SALLAH-JP/PFE/assets/images/marc.gif

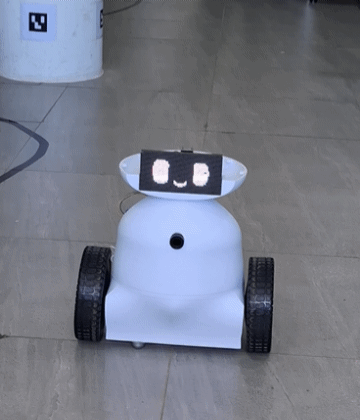
assets/images/marc.gif
