SALLAH-JP/PFE/controlMoteur/controlMoteur.ino

#include "header.h"


void setup() {
  Serial.begin(115200);

  Serial.println("Start Setup");


  //if (myIMU.begin() == false) {  // Setup without INT/RST control (Not Recommended)
  while (imu.beginSPI(BNO08X_CS, BNO08X_INT, BNO08X_RST) == false) {
    Serial.println("BNO08x not detected at default I2C address. Check your jumpers and the hookup guide. Freezing...");
    delay(100);
  }
  Serial.println("BNO08x found!");


  delay(100);
  setReports();
  Serial.println("Reading events");
  delay(100);

  // IR Receiver Setup and interrupt
  IrReceiver.begin(IR_PIN, ENABLE_LED_FEEDBACK);


  // Activer les moteurs
  engine.init();

  // Moteur droit
  motorR = engine.stepperConnectToPin(STEP_PIN_R);   // STEP droit
  if (motorR) {
    motorR->setDirectionPin(DIR_PIN_R);            // DIR droit
    motorR->setEnablePin(ENA_PIN_R, false);               // EN droit
    motorR->setAutoEnable(true);
    motorR->setAcceleration(3000);
  }

  // Moteur gauche
  motorL = engine.stepperConnectToPin(STEP_PIN_L);   // STEP gauche
  if (motorL) {
    motorL->setDirectionPin(DIR_PIN_L);            // DIR gauche
    motorL->setEnablePin(ENA_PIN_L, false);               // EN gauche
    motorL->setAutoEnable(true);
    motorL->setAcceleration(3000);
  }


  // Tracking Sensor Setup
  pinMode(LEFT_SENSOR_PIN, INPUT);
  pinMode(RIGHT_SENSOR_PIN, INPUT);
  pinMode(CENTER_SENSOR_PIN, INPUT);

  setupUltrasons();

  // PID
  pidA.SetSampleTime(10);
  pidA.SetOutputLimits(-5000, 5000);
  pidA.SetMode(AUTOMATIC);

  pidV.SetSampleTime(10);
  pidV.SetOutputLimits(-45, 45);
  pidV.SetMode(AUTOMATIC);


  Serial.println("Setup Completed !");
}


void loop() {

  if (imu.wasReset()) {
    Serial.print("sensor was reset ");
    setReports();
  }

  moveCmd = 0;
  turnCmd = 0;

  readSerialCommand();


  if (lineFollowingMode) {
    lineTracking();        // suit la ligne, ignore la télécommande
  } else {
    remoteControl();       // télécommande active, pas de suivi
  }

  // filtrage passe-bas des commandes
  currentMoveCmd = moveCmd; //lowPassFilter(moveCmd, currentMoveCmd, 0.8);
  currentTurnCmd = turnCmd; //lowPassFilter(turnCmd, currentTurnCmd, 0.8);

  inputV = measureSpeed();

  if ( imu.getSensorEvent() == true) {
    if ( imu.getSensorEventID() == SENSOR_REPORTID_GAME_ROTATION_VECTOR ) {
    

      // Envoi du yaw au Pi à 10 Hz (localisation)
      static unsigned long lastYawSend = 0;
      if (millis() - lastYawSend > 100) {
        float yaw = imu.getYaw() * 180.0 / PI;
        Serial.print("Y:");
        Serial.println(yaw, 1);
        lastYawSend = millis();
      }



      // Envoi de la distance parcourue au Pi à 10 Hz
      static unsigned long lastDistSend = 0;
      if (millis() - lastDistSend > 100) {
         long posL = motorL->getCurrentPosition();
         long posR = -motorR->getCurrentPosition();   // signe inversé comme dans measureSpeed
         // distance moyenne en cm
         float stepsToCm = (PI * WHEEL_DIAMETER) / (STEPS_REV * MICRO_STEPS);
         float distL = posL * stepsToCm;
         float distR = posR * stepsToCm;
         float dist = (distL + distR) / 2.0;
         Serial.print("D:");
         Serial.println(dist, 1);
         lastDistSend = millis();
      }

      updateUltrasons();
      sendUltrasons();

      pidV.Compute();
      setpointA = EQUILIBRE + outputV;
      pidA.Compute();
    
      //Serial.print(inputA); Serial.print(" => "); Serial.println(outputA);
      //Serial.print(inputV); Serial.print(" => "); Serial.println(outputV);
    }    

  }
  

  //Serial.print(KpA); Serial.print(" => "); Serial.print(KiA); Serial.print(" => "); Serial.println(KdA);
  //Serial.print(KpV); Serial.print(" => "); Serial.print(KiV); Serial.print(" => "); Serial.println(KdV);
  //Serial.println();
  //Serial.print(currentMoveCmd); Serial.print(" => "); Serial.println(currentTurnCmd);
  setMotors(currentMoveCmd, currentTurnCmd);
  //temps();

}
