SALLAH-JP/PFE/(commit log)

2026-01-26 LedMatrix Eye + IA
2026-01-29 modif du jour
    [pyvenv.cfg]
2026-02-01 submodule : rpi-rgb-led-matrix
2026-02-01 venv delete
    [pyvenv.cfg]
2026-02-09 Premiere version fonctionnelle de l'assistant vocal
2026-02-23 Modification du jour : Matrice de Led
2026-03-19 STT avec speech_recognition de google
    Creation RobotCompagon.py (main du Projet)
2026-04-06 putain faut que je me depeche
2026-04-07 Ajout de l'interface Web
2026-04-14 Premier pas vers la version finale
2026-04-18 amelioration de la stabilite
2026-04-20 test du suivi de ligne
2026-04-20 Test de suivi de ligne + ameliorations
2026-04-25 bientot la fin
2026-04-27 Vers la fin
2026-04-28 Meilleur gestion de l'affichag et des animations de la matrices
2026-04-28 C'est vraiment la version finale je le jure
2026-06-02 Integration de la navigation sur la pade web: Début
2026-06-03 fix: Passage a un Yaw relatif pour plus de stabilité
    [camera_node.py, controlMoteur.ino, firmware_node.py, fonctions.ino, localization_node.py, maps.py]
2026-06-03 Integration de toute les nouveautés sur la page web; changement de statégie de parcours (Graphes + Dkjistra)
2026-06-05 Bonne journée de travail
2026-06-09 correctif mineure + MAJ du README
    [server.py]
2026-06-28 refactor(voice): procédural, fix astérisques et coupures TTS
    [navigation_node.py, server.py, webbridge_node.py]
