SALLAH-JP/PFE/(notices)

Notices in the files:
README.md:
License: MIT
